ian-ross/link-434/README.md

# link-434

ISM 434 MHz band communications system:

 - Silicon Labs EFM8UB3 microcontroller.
 - Maxim MAX7032 434 MHz transceiver.
 - USB "dongle" form factor.
 - Flexible interface: USB or UART via 0.1" header.
 - C2 programming interface.
