ian-ross/link-434/doc/design-notes.odt

Link-434 Design Notes

# Microcontroller interface

- The microcontroller is a Silicon Labs EFM8UB3 device. This has an 8051-compatible core, 40K of flash and 3328 bytes of RAM (256 internal, 2K external, 1K USB buffers).
- Two GPIOs go to LEDs, one to a momentary contact switch: the switch is attached to pin P2.0, which is also used by the USB bootloader to decide when to enter bootloader mode. If P2.0 is held closed at POR, then the bootloader is activated. By wiring the switch to P2.0, we can use this as a failsafe to activate the bootloader at POR, while using the pin as a normal GPIO once the application code is started.
- A UART connection is brought out to a header for mounting the Link-434 on the main Mini-Mapper board, and the EFM8UB3’s USB connection is used for connecting the Link-434 to a PC.
- Three GPIOs are used to manage the custom serial interface to the MAX7032 configuration registers.
- Three GPIOs are used to connect to the ENABLE, T/R and DATA pins on the MAX7032.
- The EFM8UB3 is clocked from its internal 48 MHz oscillator, with USB clock recovery to improve frequency accuracy when connected to USB. (When not connected to USB, the clock has 1.5% frequency accuracy, which should be good enough.)

# Transceiver interface

- The 434 MHz transceiver is a Maxim MAX7032 device. This has a custom 3-wire serial configuration interface, a 3-pin custom interface for data transmission and reception, and requires only external passives and an antenna.
- The passive components needed to support the MAX7032 are taken directly from the device datasheet.

# Power

- Both the MAX7032 and the EFM8UB3 run off 3.3V.
- The EFM8UB3 has an internal LDO to convert a USB 5V supply to 3.3V and provide this for system power on the EFM8UB3’s VDD pin.
- There are two modes of operation: USB-powered, in which case the 3.3V supply for the MAX7032 is supplied from the EFM8UB3’s internal regulator; header-powered, where the 3.3V supply for the MAX7032 and EFM8UB3 is supplied via a 0.1” header.
- When running in header-powered mode, the VBUS and VDD pins of the EFM8UB3 should be shorted together. For simplicity, this is done with a jumper.

# Microcontroller programming

- Programming of the EFM8UB3 is done using the USB bootloader loaded into EFM8UB3 devices at the factory. The C2 programming interface signals are not used. I’m now wondering if this is the best idea. It wouldn’t be hard to bring the C2 signals out on the header on the Link-434 board, and it might be useful, especially if I can get C2 debugging going somehow.
- Using the USB bootloader means no debugging on the Link-434 itself, but most of the software will be developed on the Thunderboard dev board with a MAX7032 simulator so this should be OK. Once the USB interface to the EFM8UB3 is set up, it can be used for printf debugging.

# USB on the EFM8UB3

- There are very few examples of using USB on the EFM8UB3. The only real example is a HID keyboard application.
- The USB library code is divided into the efm8_usb directory and some definitions in the peripheral_driver/usb_0.h header.
- I’ve done some reorganisation of the USB library code to make it a bit more manageable, but there’s still quite a lot involved. It’s going to take a little bit of work to get it going.
