ian-ross/link-434/doc/signals.ods

MAX7032 Signals
RSSI | Analog output | Connect to ADC input on EFM8U3
T/~R | Digital input | Connect to GPIO on EFM8U3
ENABLE | Digital input | Connect to GPIO on EFM8U3
DATA | Digital input/output | Connect to interrupt/timer-capable GPIO on EFM8U3
CLKOUT | Digital output | ???
~CS | Digital input | Connect to GPIO on EFM8U3
DIO | Digital input/output | Connect to I2C data line on EFM8U3
SCLK | Digital input | Connect to I2C clock output on EFM8U3
EFM8U3 Signals
P1.6 (ADC0.14) | ADC input | RSSI from MAX7032
P0.2 | GPIO output | T/~R on MAX7032
P0.1 | GPIO output | ENABLE on MAX7032
P0.0 (INT0.0) | GPIO input/output | DATA on MAX7032 | <==== This needs to be able to do timer capture on input for preamble processing
 |  |  | (and to be switchable to output from a PCA timer)
P1.5 | GPIO output | ~CS on MAX7032
P1.4 | I2C clock | SCLK on MAX7032
P1.3 | I2C data | DIO on MAX7032
P0.4 (UART1_TX) | UART TX | UART TX on header
P0.5 (UART1_RX) | UART RX | UART RX on header
VBUS | VBUS | USB-A edge connector
GND | USB GND | USB-A edge connector
D+ | USB D+ | USB-A edge connector
D- | USB D- | USB-A edge connector
P1.0 | GPIO output | LED1 |  | P0.3
P1.1 | GPIO output | LED2 |  | P0.6
P1.2 | GPIO input | SW1 |  | P0.7
