ian-ross/link-434/hardware/link-434.kicad_pcb

## KiCad design hardware/link-434.kicad_pcb (2020-10-21)

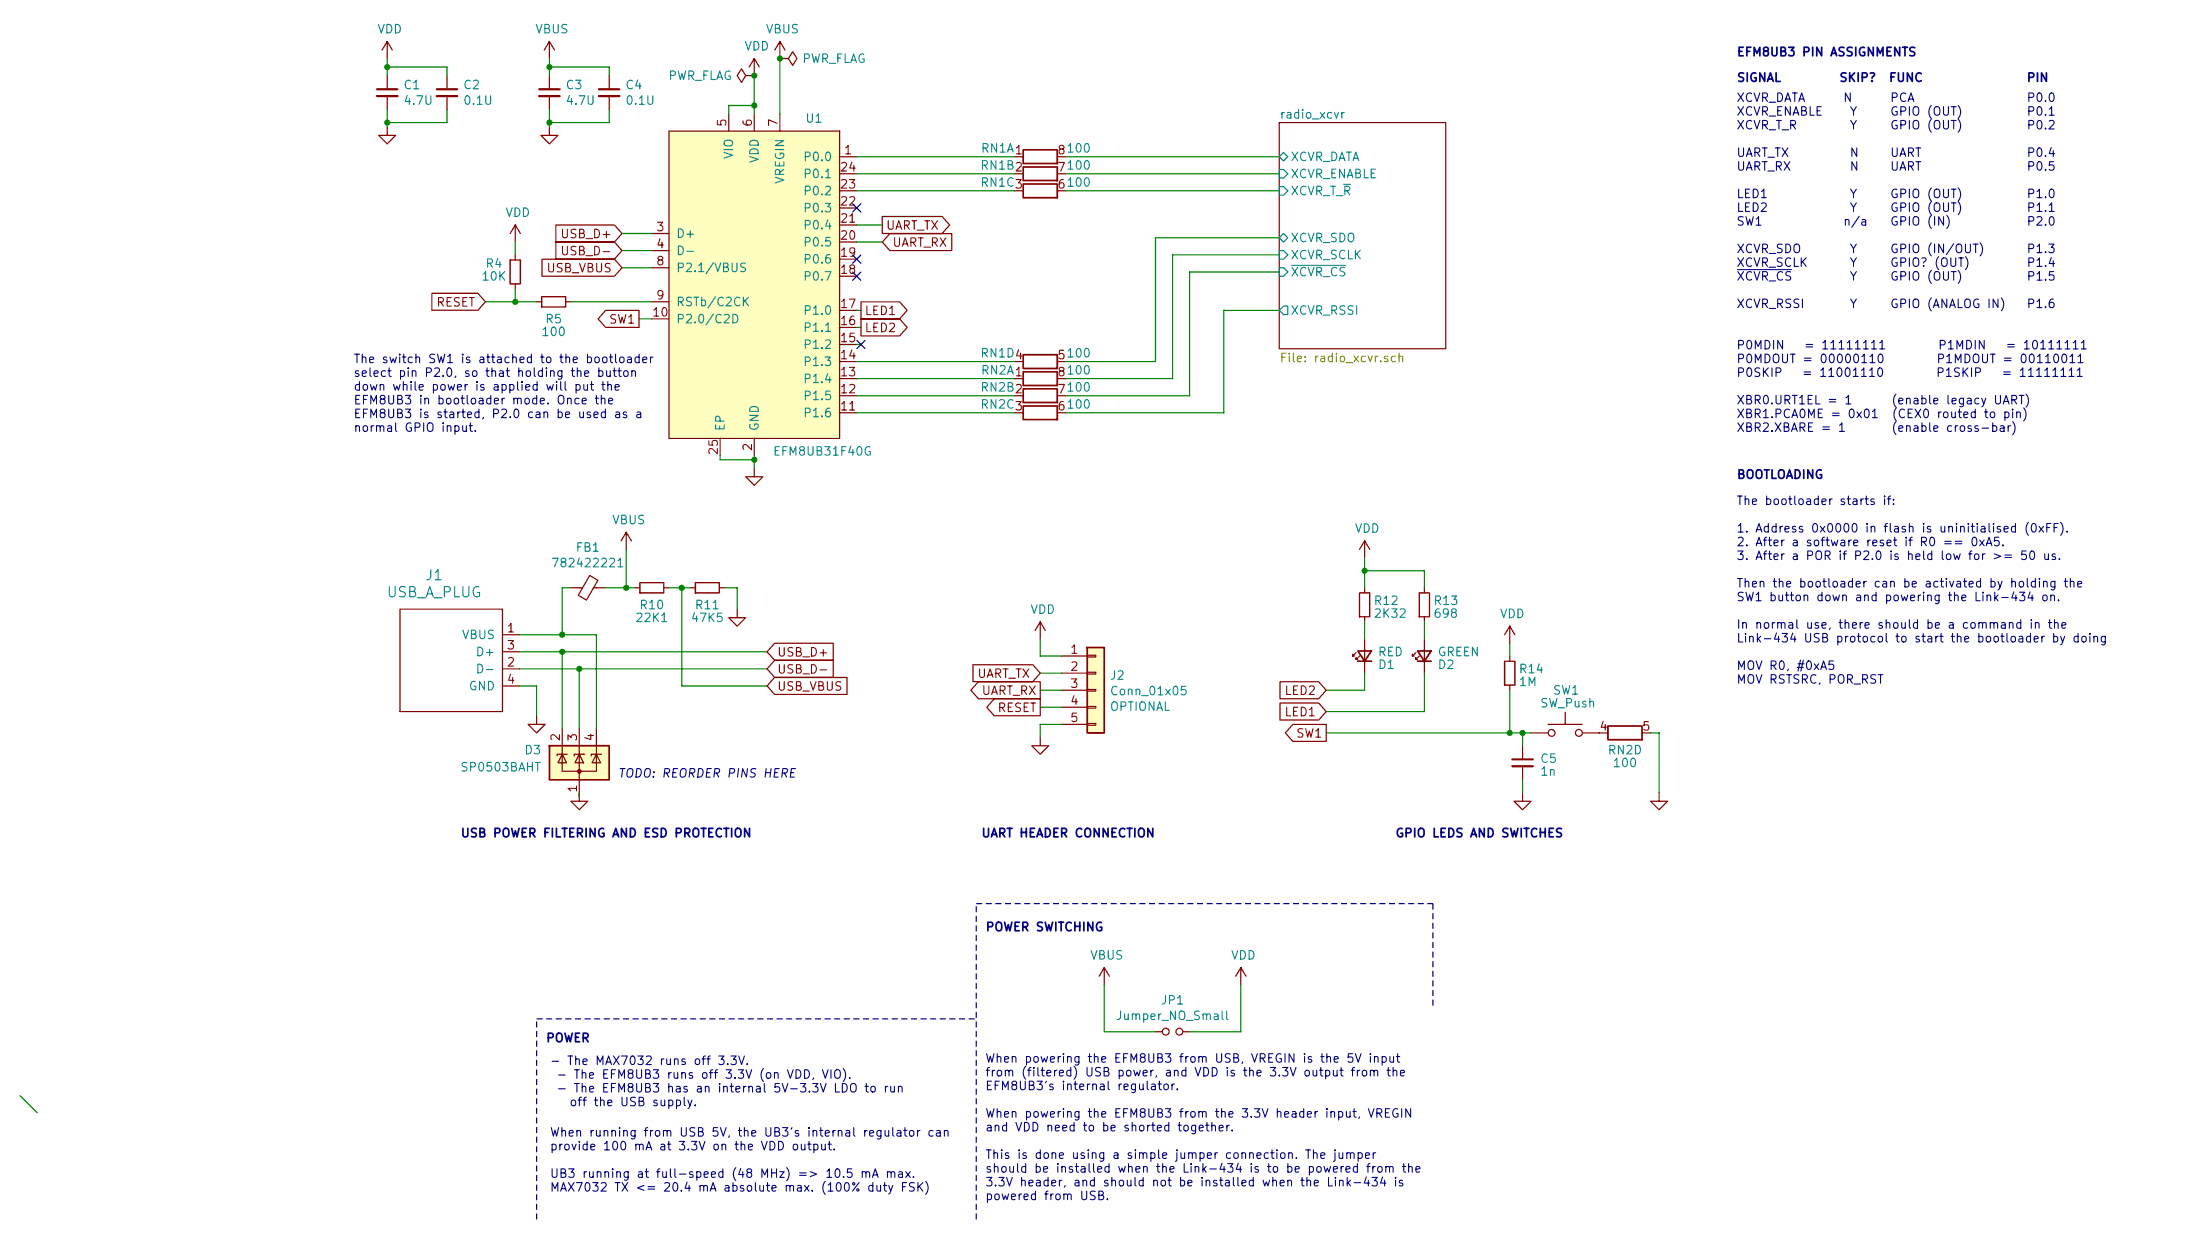
[picture p1: schematic link-434.sch]

Parts:
C1, C3: 4.7U; C_0402_1005Metric
C2, C4: 0.1U; C_0402_1005Metric
C5: 1n; C_0402_1005Metric
D1: RED; LED_0805_2012Metric
D2: GREEN; LED_0805_2012Metric
D3: SP0503BAHT; SOT-143; MPN SP0503BAHTG
FB1: 782422221; Ferrite_0402_1005Metric; MPN 782422221
J1: USB_A_PLUG; usb-a-edge
J2: Conn_01x05; PinHeader_1x05_P2.54mm_Vertical
JP1: Jumper_NO_Small; PinHeader_1x02_P2.54mm_Vertical
R4: 10K; R_0402_1005Metric
R5: 100; R_0402_1005Metric
R10: 22K1; R_0402_1005Metric
R11: 47K5; R_0402_1005Metric
R12: 2K32; R_0402_1005Metric
R13: 698; R_0402_1005Metric
R14: 1M; R_0402_1005Metric
RN1, RN2: 100; CAT16101J4LF
SW1: SW_Push; PTS526SM15SMTR2LFS; MPN PTS526 SM15 SMTR2 LFS
U1: EFM8UB31F40G; QFN-24-1EP_4x4mm_P0.5mm_EP2.6x2.6mm_ThermalVias; MPN EFM8UB31F40G-A-QFN24

Connections:
/radio_xcvr/XCVR_DATA: RN1.8 (R1.2); also elsewhere on the board
/radio_xcvr/XCVR_ENABLE: RN1.7 (R2.2); also elsewhere on the board
/radio_xcvr/XCVR_RSSI: RN2.6 (R3.2); also elsewhere on the board
/radio_xcvr/XCVR_SCLK: RN2.8 (R1.2); also elsewhere on the board
/radio_xcvr/XCVR_SDO: RN1.5 (R4.2); also elsewhere on the board
/radio_xcvr/XCVR_T_~R: RN1.6 (R3.2); also elsewhere on the board
/radio_xcvr/~XCVR_CS: RN2.7 (R2.2); also elsewhere on the board
GND: C1.2, C2.2, C3.2, C4.2, C5.2, D3.1 (A), J1.4 (GND), J2.5, R11.2, RN2.5 (R4.2), U1.2 (GND), U1.25 (EP); also elsewhere on the board
LED1: D2.1 (K), U1.17 (P1.0)
LED2: D1.1 (K), U1.16 (P1.1)
unnamed: D1.2 (A), R12.1
unnamed: D2.2 (A), R13.1
unnamed: D3.4 (K), FB1.2, J1.1 (VBUS)
unnamed: R5.2, U1.9 (RSTb/C2CK)
unnamed: RN1.1 (R1.1), U1.1 (P0.0)
unnamed: RN1.2 (R2.1), U1.24 (P0.1)
unnamed: RN1.3 (R3.1), U1.23 (P0.2)
unnamed: RN1.4 (R4.1), U1.14 (P1.3)
unnamed: RN2.1 (R1.1), U1.13 (P1.4)
unnamed: RN2.2 (R2.1), U1.12 (P1.5)
unnamed: RN2.3 (R3.1), U1.11 (P1.6)
unnamed: RN2.4 (R4.1), SW1.2
RESET: J2.4, R4.2, R5.1
SW1: C5.1, R14.1, SW1.1, U1.10 (P2.0/C2D)
UART_RX: J2.3, U1.20 (P0.5)
UART_TX: J2.2, U1.21 (P0.4)
USB_D+: D3.2 (K), J1.3 (D+), U1.3 (D+)
USB_D-: D3.3 (K), J1.2 (D-), U1.4 (D-)
USB_VBUS: R10.2, R11.1, U1.8 (P2.1/VBUS)
VBUS: C3.1, C4.1, FB1.1, JP1.1, R10.1, U1.7 (VREGIN)
VDD: C1.1, C2.1, J2.1, JP1.2, R4.1, R12.2, R13.2, R14.2, U1.5 (VIO), U1.6 (VDD); also elsewhere on the board

Notes on the sheet:
BOOTLOADING
When powering the EFM8UB3 from USB, VREGIN is the 5V input from (filtered) USB power, and VDD is the 3.3V output from the EFM8UB3's internal regulator. When powering the EFM8UB3 from the 3.3V header input, VREGIN and VDD need to be shorted together. This is done using a simple jumper connection. Th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
POWER SWITCHING
When running from USB 5V, the UB3's internal regulator can provide 100 mA at 3.3V on the VDD output. UB3 running at full-speed (48 MHz) => 10.5 mA max. MAX7032 TX <= 20.4 mA absolute max. (100% duty FSK)
POWER
- The MAX7032 runs off 3.3V. - The EFM8UB3 runs off 3.3V (on VDD, VIO). - The EFM8UB3 has an internal 5V-3.3V LDO to run off the USB supply.
USB POWER FILTERING AND ESD PROTECTION
GPIO LEDS AND SWITCHES
UART HEADER CONNECTION
EFM8UB3 PIN ASSIGNMENTS
XCVR_DATA XCVR_ENABLE XCVR_T_R UART_TX UART_RX LED1 LED2 SW1 XCVR_SDO XCVR_SCLK ~XCVR_CS~ XCVR_RSSI
N Y Y N N Y Y n/a Y Y Y Y
PCA GPIO (OUT) GPIO (OUT) UART UART GPIO (OUT) GPIO (OUT) GPIO (IN) GPIO (IN/OUT) GPIO? (OUT) GPIO (OUT) GPIO (ANALOG IN)
P0.0 P0.1 P0.2 P0.4 P0.5 P1.0 P1.1 P2.0 P1.3 P1.4 P1.5 P1.6
P0MDIN = 11111111 P1MDIN = 10111111 P0MDOUT = 00000110 P1MDOUT = 00110011 P0SKIP = 11001110 P1SKIP = 11111111 XBR0.URT1EL = 1 (enable legacy UART) XBR1.PCA0ME = 0x01 (CEX0 routed to pin) XBR2.XBARE = 1 (enable cross-bar)
SIGNAL SKIP? FUNC PIN
The bootloader starts if: 1. Address 0x0000 in flash is uninitialised (0xFF). 2. After a software reset if R0 == 0xA5. 3. After a POR if P2.0 is held low for >= 50 us. Then the bootloader can be activated by holding the SW1 button down and powering the Link-434 on. In normal use, there should be a 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
The switch SW1 is attached to the bootloader select pin P2.0, so that holding the button down while power is applied will put the EFM8UB3 in bootloader mode. Once the EFM8UB3 is started, P2.0 can be used as a normal GPIO input.
TODO: REORDER PINS HERE

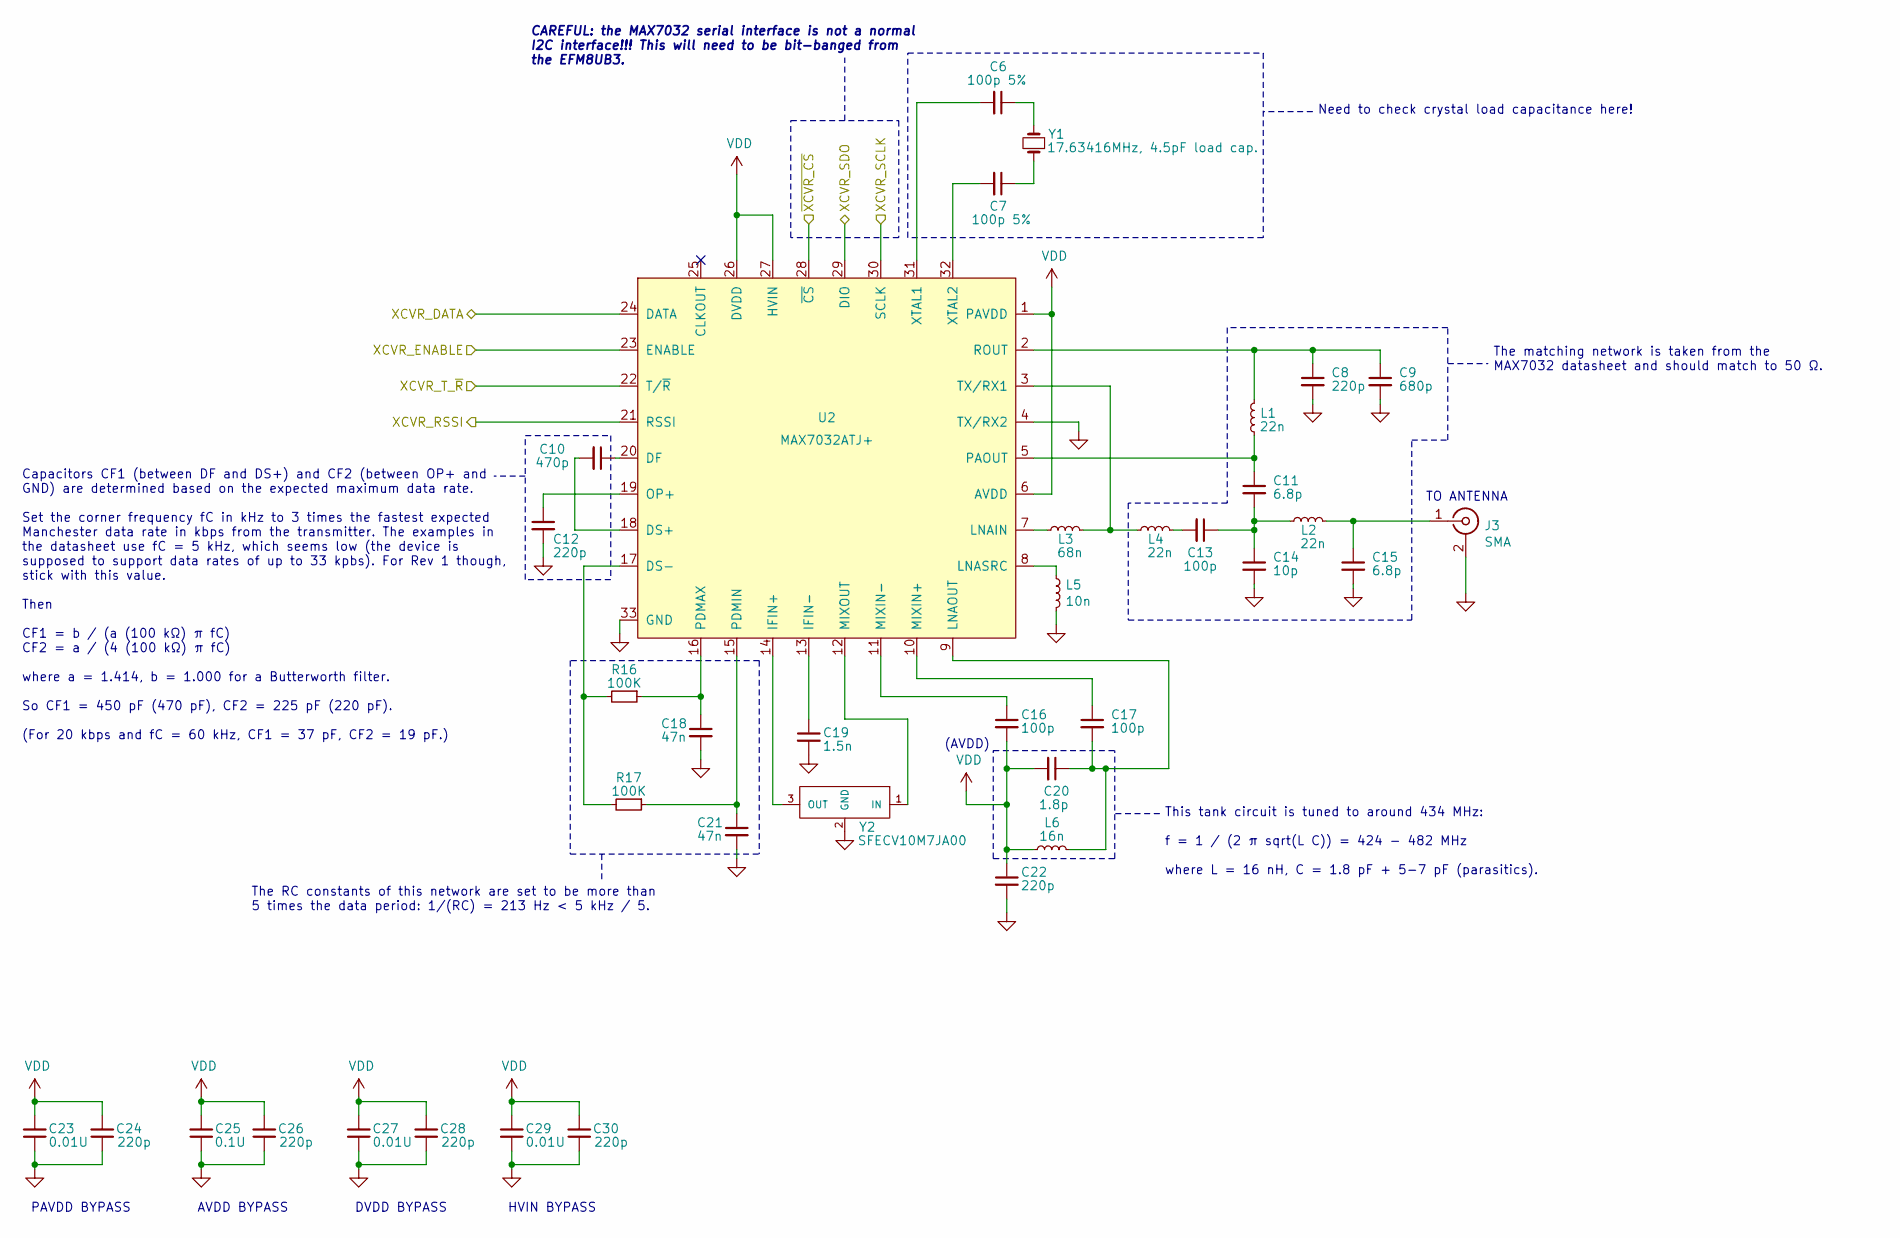
[picture p2: schematic radio_xcvr.sch]

Parts:
C6, C7: 100p 5%; C_0402_1005Metric
C8, C12, C22, C24, C26, C28, C30: 220p; C_0402_1005Metric
C9: 680p; C_0402_1005Metric
C10: 470p; C_0402_1005Metric
C11, C15: 6.8p; C_0402_1005Metric
C13, C16, C17: 100p; C_0402_1005Metric
C14: 10p; C_0402_1005Metric
C18, C21: 47n; C_0402_1005Metric
C19: 1.5n; C_0402_1005Metric
C20: 1.8p; C_0402_1005Metric
C23, C27, C29: 0.01U; C_0402_1005Metric
C25: 0.1U; C_0402_1005Metric
J3: SMA; SMA_Linx_CONSMA001_Vertical; MPN CONSMA001-C-G
L1, L2, L4: 22n; L_Coilcraft_0603CS; MPN 0603CS-22NXJLW
L3: 68n; L_Coilcraft_0603CS; MPN 0603CS-68NXJLW
L5: 10n; L_Coilcraft_0603CS; MPN 0603CS-10NXJLU
L6: 16n; L_Murata_LQW18ASxxxx00x; MPN LQW18AS16NJ00D
R16, R17: 100K; R_0402_1005Metric
U2: MAX7032ATJ+; QFN-32-1EP_5x5mm_P0.5mm_EP3.1x3.1mm_ThermalVias; MPN MAX7032ATJ+
Y1: 17.63416MHz, 4.5pF load cap.; Crystal_SMD_HC49-SD; MPN 017301
Y2: SFECV10M7JA00; Resonator_SMD_muRata_SFECV-3Pin_6.9x2.9mm; MPN SFECV10M7JA00-R0

Connections:
/radio_xcvr/XCVR_DATA: U2.24 (DATA); also elsewhere on the board
/radio_xcvr/XCVR_ENABLE: U2.23 (ENABLE); also elsewhere on the board
/radio_xcvr/XCVR_RSSI: U2.21 (RSSI); also elsewhere on the board
/radio_xcvr/XCVR_SCLK: U2.30 (SCLK); also elsewhere on the board
/radio_xcvr/XCVR_SDO: U2.29 (DIO); also elsewhere on the board
/radio_xcvr/XCVR_T_~R: U2.22 (T/~R); also elsewhere on the board
/radio_xcvr/~XCVR_CS: U2.28 (~CS); also elsewhere on the board
GND: C8.2, C9.2, C12.2, C14.2, C15.2, C18.2, C19.2, C21.2, C22.2, C23.1, C24.1, C25.1, C26.1, C27.1, C28.1, C29.1, C30.1, J3.2 (Ext), L5.2, U2.4 (TX/RX2), U2.33 (GND), Y2.2 (GND); also elsewhere on the board
unnamed: C6.1, Y1.2
unnamed: C6.2, U2.31 (XTAL1)
unnamed: C7.1, Y1.1
unnamed: C7.2, U2.32 (XTAL2)
unnamed: C8.1, C9.1, L1.2, U2.2 (ROUT)
unnamed: C10.1, U2.20 (DF)
unnamed: C10.2, U2.18 (DS+)
unnamed: C11.1, L1.1, U2.5 (PAOUT)
unnamed: C11.2, C13.1, C14.1, L2.1
unnamed: C12.1, U2.19 (OP+)
unnamed: C13.2, L4.2
unnamed: C15.1, J3.1 (In), L2.2
unnamed: C16.1, U2.11 (MIXIN-)
unnamed: C17.1, U2.10 (MIXIN+)
unnamed: C17.2, C20.1, L6.2, U2.9 (LNAOUT)
unnamed: C18.1, R16.1, U2.16 (PDMAX)
unnamed: C19.1, U2.13 (IFIN-)
unnamed: C21.1, R17.1, U2.15 (PDMIN)
unnamed: L3.1, U2.7 (LNAIN)
unnamed: L3.2, L4.1, U2.3 (TX/RX1)
unnamed: L5.1, U2.8 (LNASRC)
unnamed: R16.2, R17.2, U2.17 (DS-)
unnamed: U2.12 (MIXOUT), Y2.1 (IN)
unnamed: U2.14 (IFIN+), Y2.3 (OUT)
VDD: C16.2, C20.2, C22.1, C23.2, C24.2, C25.2, C26.2, C27.2, C28.2, C29.2, C30.2, L6.1, U2.1 (PAVDD), U2.6 (AVDD), U2.26 (DVDD), U2.27 (HVIN); also elsewhere on the board

Notes on the sheet:
TO ANTENNA
PAVDD BYPASS
AVDD BYPASS
(AVDD)
DVDD BYPASS
HVIN BYPASS
Capacitors CF1 (between DF and DS+) and CF2 (between OP+ and GND) are determined based on the expected maximum data rate. Set the corner frequency fC in kHz to 3 times the fastest expected Manchester data rate in kbps from the transmitter. The examples in the datasheet use fC = 5 kHz, which seems l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
The RC constants of this network are set to be more than 5 times the data period: 1/(RC) = 213 Hz < 5 kHz / 5.
This tank circuit is tuned to around 434 MHz: f = 1 / (2 π sqrt(L C)) = 424 - 482 MHz where L = 16 nH, C = 1.8 pF + 5-7 pF (parasitics).
The matching network is taken from the MAX7032 datasheet and should match to 50 Ω.
CAREFUL: the MAX7032 serial interface is not a normal I2C interface!!! This will need to be bit-banged from the EFM8UB3.
Need to check crystal load capacitance here!

Board: 2 copper layers, 60 parts (0 on the bottom side), 55 nets, no tracks yet.
