ian-ross/link-434/(commit log)

2020-09-26 Initial schematic capture
    [efm8ubx-comparison.ods, link-434.kicad_pcb, link-434.sch, signals.ods]
2020-10-14 Thunderboard assembly blinky
2020-10-20 Schematic reorganisation
    [efm8ub3-power-switching.ods, efm8ubx-comparison.ods, link-434.sch, radio_xcvr.sch]
2020-10-21 Schematic checklist
    [link-434.kicad_pcb, link-434.sch, radio_xcvr.sch]
